plaetzchen/tapsterbot/BOM_metric.md

## Tapster Bill of Materials (Metric):

Anything on the normal BOM except for metric nuts and bolds (I found most of the other stuff on Amazon)

### Metric nuts and bolts
    Socket Bolts:
    Qty     Description              Long Description:                               Unit Price
    4       DIN 912 A2 M2.5 12mm     Special Steel Hexagon Socket Cap Screw          0.13€ per piece
    6       DIN 912 A2 M3 18mm       Special Steel Hexagon Socket Cap Screw          0.13€ per piece
    50      DIN 912 A2 M5 20mm       Special Steel Hexagon Socket Cap Screw          0.10€ per piece
    10      DIN 912 A2 M5 25mm       Special Steel Hexagon Socket Cap Screw          0.12€ per piece
    6       DIN 912 A2 M5 30mm       Special Steel Hexagon Socket Cap Screw          0.11€ per piece

    Hex Nuts:
    Qty     Description             Long Description:                                       Unit Price
    4       M2.5 Nylon Nuts         M2.5 Nylon Mutter                                       10,54€ per pack of 8 (Amazon)
    6       DIN 934 A2 M3 Nuts      Special Steel Hex Nut                                   0.02€ per piece
    48      DIN 439 A2 BM5          Special Steel Hex Nut (low profile)                     0.03€ per piece
    18      DIN 985 A2 M5           Special Steel Sel Locking Hex Nut                       0.05€ per piece
