plaetzchen/tapsterbot/src/tweetscreen.png

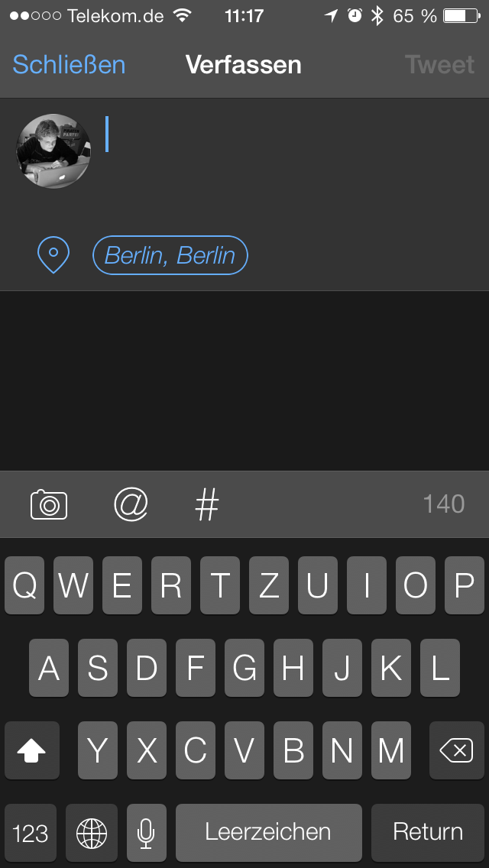
src/tweetscreen.png
