plaetzchen/tapsterbot/(list of files, drawings)

Other design files:
fritzing/tapsterbot_instructions.fzz
fritzing/tapsterbot_pcb.fzz
