plaetzchen/tapsterbot/(commit log)

2013-12-16 Added metric BOM (not yet tested)
2013-12-18 Save calibration to file and load it on demand
2014-01-09 Added fritzing files for building instructions and a custom pcb
    [tapsterbot_instructions.fzz, tapsterbot_pcb.fzz]
2014-01-09 Added directory for fritzing files
    [tapsterbot_instructions.fzz, tapsterbot_pcb.fzz]
2014-01-16 Updated instructions
    [tapsterbot_instructions.fzz, tapsterbot_pcb.fzz]
2014-01-17 Now going to 0 before calibrating
2014-01-17 Forgot to insert the stylus
